jonathanTorf/3d-printer-v2/README.md

[Onshape](https://cad.onshape.com/documents/b80cc066c462fb426581e072/w/e03162f6bc79a39a6e4ea033/e/0e22e25e1b52de5b156d5392)

[Oshwlab](https://oshwlab.com/jonatan_t/stepper-motor-to-driver-board_2)

[Showcase video](https://youtu.be/BTVg7voFzN0)
