jonathanTorf/3d-printer-v2/project presentation/הצגת קהל פרויכט יוד 2026 - יונתן טורפשטיין.pptx

## פרויקט י' 2026

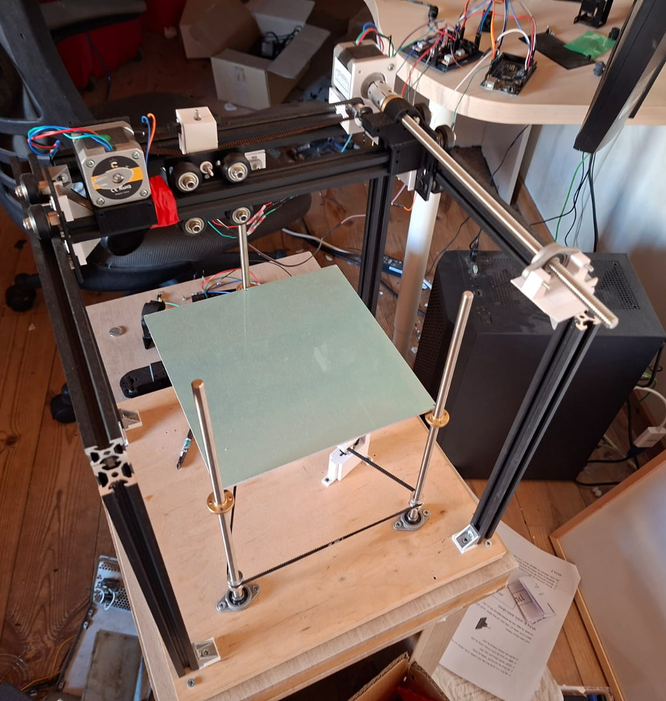
[picture p1: figure]

יונתן טורפשטיין

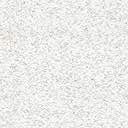
[picture p2: figure]

## מה הפרויקט שלי?

מדפסת תלת ממד שיכולה לקרוא קמצי gcode ולזוז כמו מדפסת אמיתית.
הפרויקט משתמש בבורג מוביל(lead screw) לציר ה-X, ורצועה לציר ה-Y, ציר ה-Z משתמש ברצועה כדי לסובב 3 ברגים ביחד.

שרטות .BOM

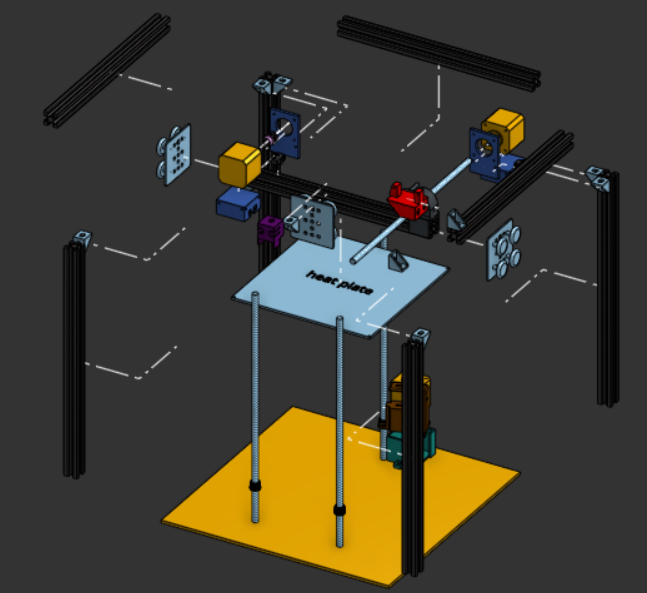
[picture p3: figure]

ציר Z.

מסילות X ו-Y.

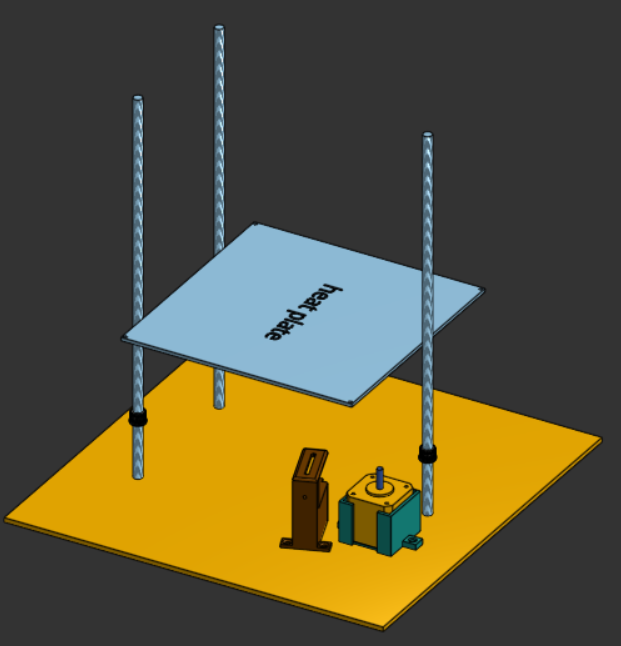
[picture p4: figure]
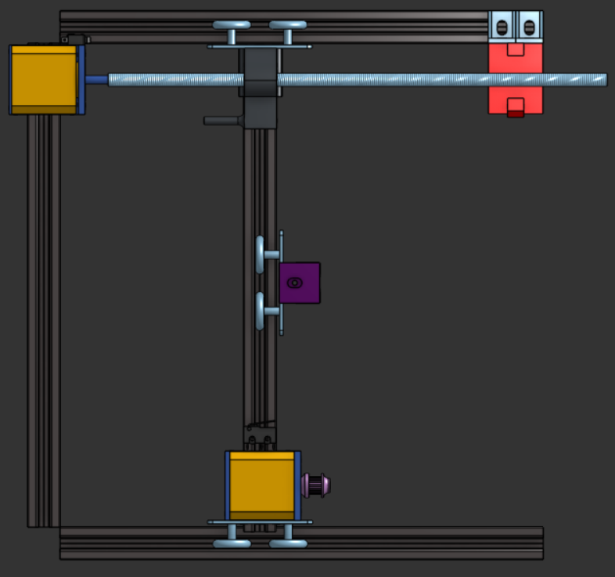
[picture p5: figure]

## עיצוב קודם נגד חדש

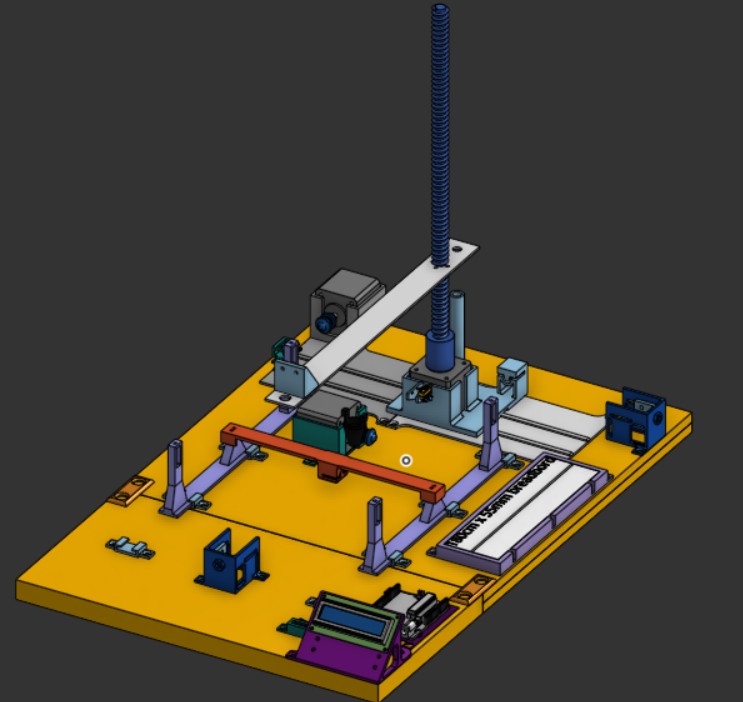
[picture p6: figure]

## אלקטרוניקה

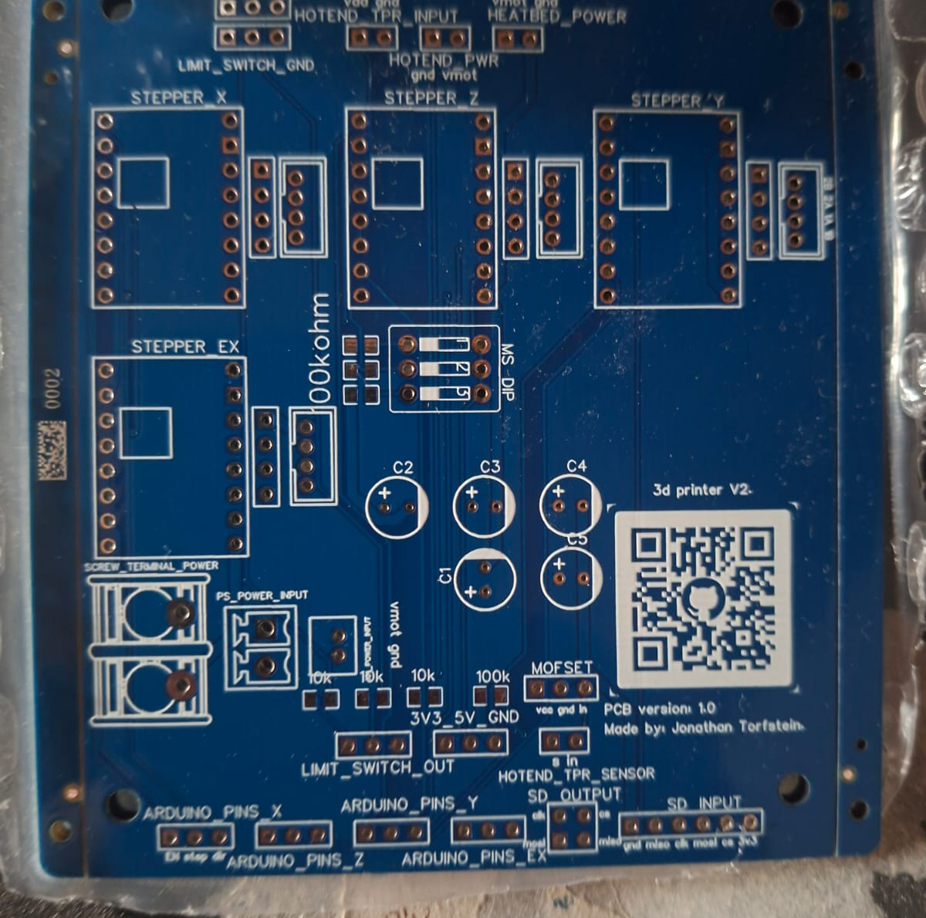
[picture p7: figure]
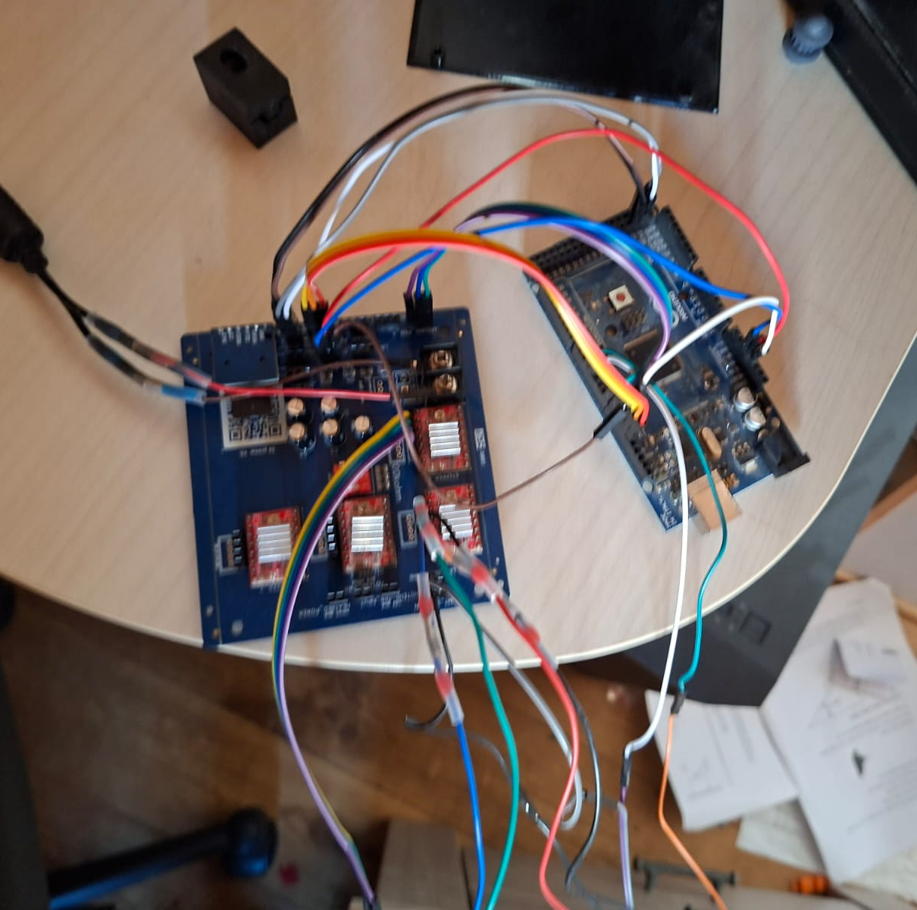
[picture p8: figure]

בפרויקט הזה השתמשתי ב-PCB, הכנתי אותו בעצמי באתר easyEDA ושלכתי אותו לייצור באתר JLCPCB.
לבקר אני משתמש ב-Arduino mega, בשביל המנועים אני משתמש ב-nema17 stepper, אם הדרייבר A4988.

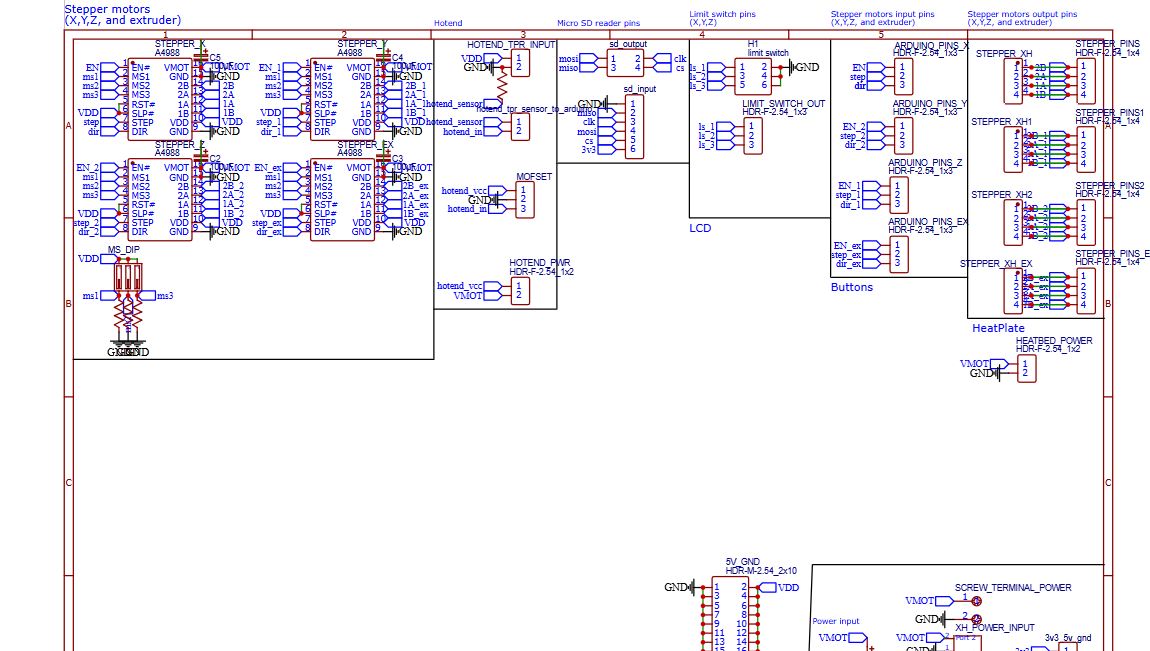
[picture p9: figure]
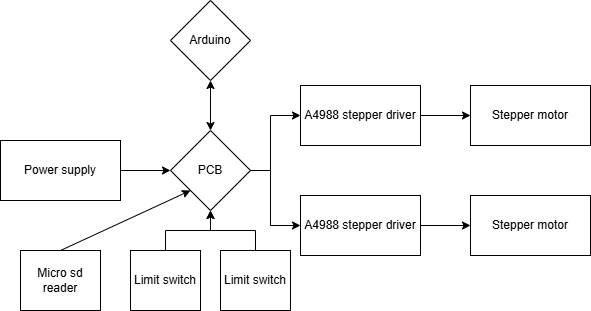
[picture p10: figure]

## Slide 5

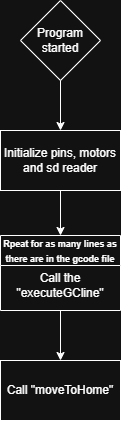
[picture p11: figure]
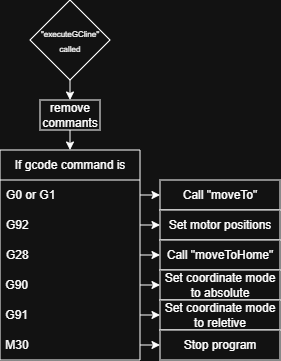
[picture p12: figure]

:gcode

דוגמה לשורה של gcode:
G1 X67 Y69 E420 F1000 ;comment
Move(67, 69, posZ, 420, 1000); //comment

## Slide 6

תוכנה.

מתוך: printer.cpp

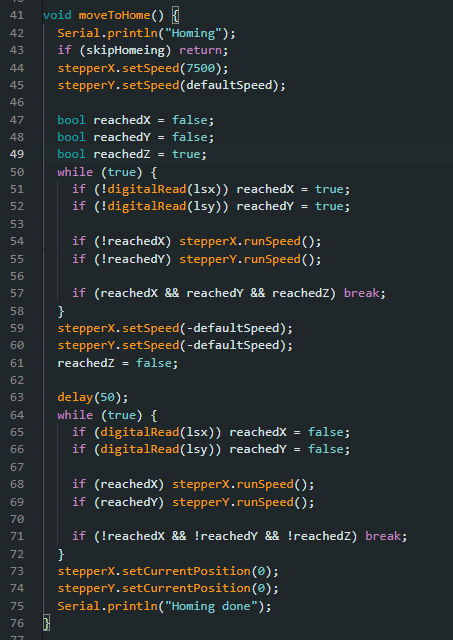
[picture p13: figure]

מתוך: movemant.h

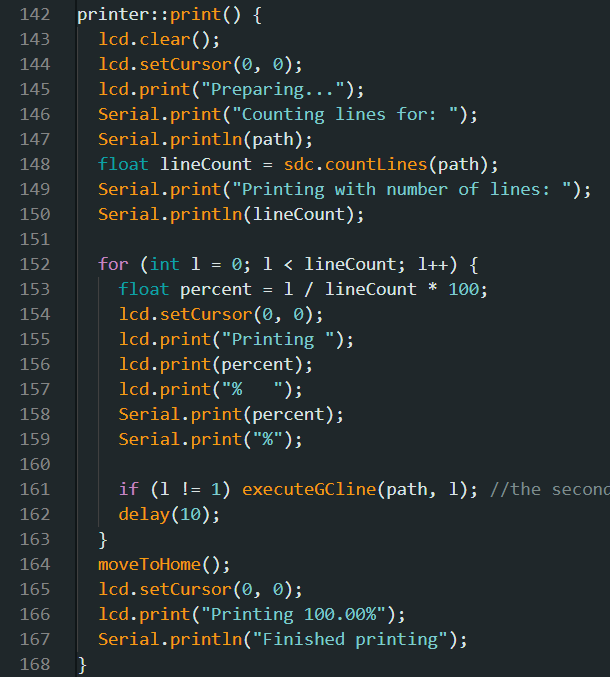
[picture p14: figure]

עדיין יש לי בעיות בתוכנה שלא הצלחתי לפתור, לדוגמא: בפונקציה שמחזירה את המדפסת ל-0,0 ציר ה-X תמיד הולך לאט, גם כשניסיתי להגביר לו את המהירות, אבל רק בפעם הראשונה שאני קורא לפונקציה הזאת.
