jonathanTorf/3d-printer-v2/project presentation/ספר פרוייקט כיתה י', יונתן טורפשטיין.docx

0 – שער:

פרויקט יוד:

מדפסת תלת ממד

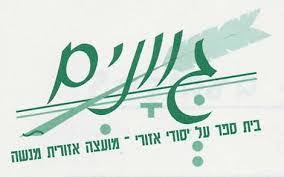
[picture p15: figure]

שם המגיש: יונתן טורפשטיין

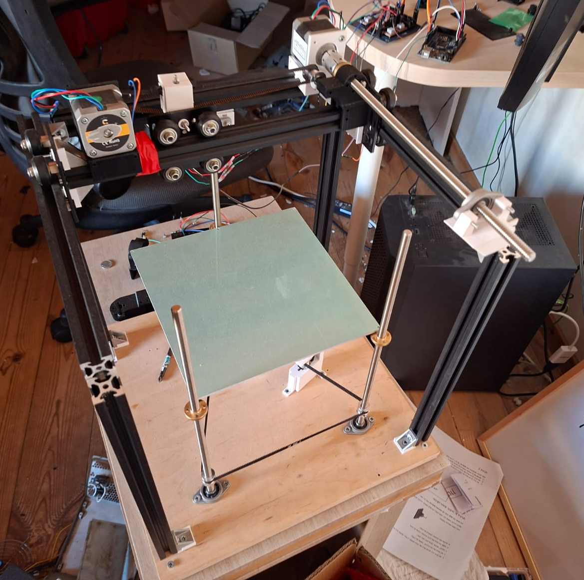
[picture p16: figure]

תאריך הגשה: 24.5.2026

של הפרויקט.github (https://github.com/jonathanTorf/3d-printer-v2/tree/main/)

1 - תוכן עניינים:

0: שער.

1: תוכן עניינים.

2: תקציר.

.gcode 2.1: הסבר קצר על

3: דרישות פרויקט.

4: מידול.-6

7-9: אלקטרוניקה.

.PCB - 10

11 – סכמת מלבנים של האלקטרוניקה.

12 – תרשימי זרימה.

12.1 – תוכנה. (https://github.com/jonathanTorf/3d-printer-v2/tree/main/arduinoIDE/main)

12.2 – סרטון הצלחה. (https://youtu.be/BTVg7voFzN0)

13 – רפלקציה.

2 – תקציר:

זה הניסיון השני שלי בלהכין מדפסת תלת ממד, בניסיון הראשון היה לי עיצוב שלא מאפשר תזוזה יציבה(אונשייפ של העיצוב הקודם (https://cad.onshape.com/documents/b952cc3ae6dde4798fa6cef6/w/a75674ccd77912fe6442e073/e/6845e0cde51841863a819568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)) המודל נבנה על הרעיון שציר ה-Z רוכב על ציר ה-Y עם מסילה מודפסת. במודל החדש הכנתי שלד יציב עם השראה ממדפסות אמיתיות ועבדתי עם ספריות להכין תזוזה שמטפלת בכמה מנועים באותו הזמן.

במהלך הבדיקות שרפתי 2 מהדרייברים שלי אז לא הגעתי ללהפעיל את ציר ה- Zואת האקסטרודר.
המודל הזה עדיין לא מדפיס בשלוש ממדים, הגעתי לציור דו ממדי מתוך קובץ.gcode

אני מתכנן להמשיך את הפרויקט הזה אחרי ההגשה עד שזה יוכל להדפיס חלקים שלמים.

:gcode – הסבר קצר על2.1

?gcodeמהו

בעיקר משומשים במכונות ייצורgcode סוג קובץ שמכיל בעיקר הוראות לתזוזה של מנועים, קבצי
.CNCכמו מדפסות תלת ממד ומכונות

נראית?gcodeאיך שורה של

G1 X67 Y69 E420 F1000

מחולקת לשני חלקים: gcode שורה ב-

: סוג הפקודה(במקרה הזה לזוז).G1

: הפרמטרים.X67 Y69 E420 F1000

זה הציר של האקסטרודר(התוכנה E מתכוונים לשני צירי התזוזה, Y ו-X
מתייחסת אלוו כמו אל ציר תזוזה).

המספרים שאחריהם הם כמה כל ציר צריך לזוז במילימטרים.

זה המהירות שלF זה המהירות של המנועים, כל המנועים צריכים להגיע ליעד שלהם באותו הזמן, F
המנוע שצריך לזוז הכי הרבה, המנועים האחרים זזים מאתים כדי שמשך התזוזה שלהם יהיה זהה.
המהירות היא בצעדים לשנייה.

3 – דרישות מהפרויקט:

gcode1: קריאה ועיבוד של קבצי

2: תזוזה מסונכרנת על צירים שיכולה להגיע לכל נקודה על המיטה.

4 – מידול:

Onshap assembly (https://cad.onshape.com/documents/b80cc066c462fb426581e072/w/e03162f6bc79a39a6e4ea033/e/0e22e25e1b52de5b156d5392):

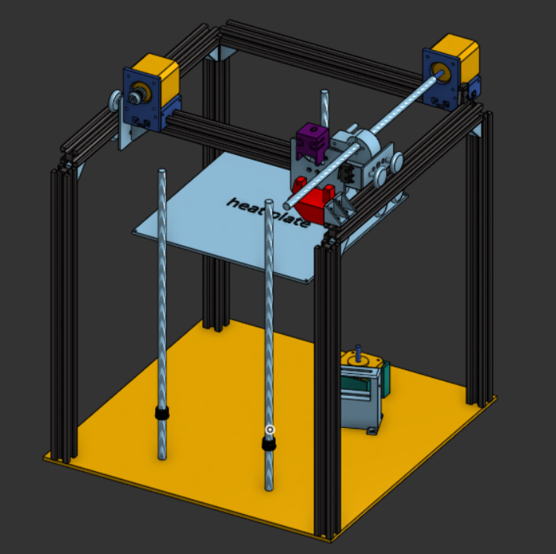
[picture p17: figure]

תיקיית שרטוטים. (https://cad.onshape.com/documents/b80cc066c462fb426581e072/w/e03162f6bc79a39a6e4ea033/e/42440a0ae2f46dab51a842b0)

Screw and belt holderשם החלק:

תמונה:

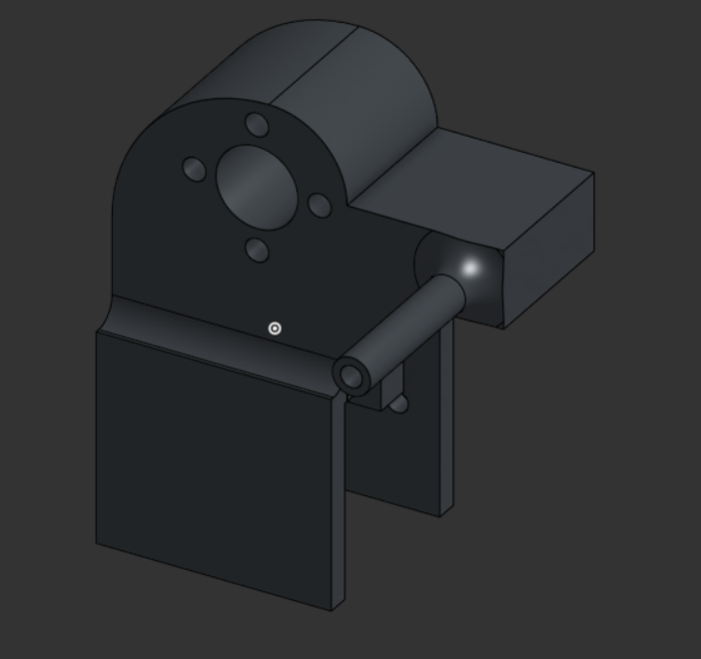
[picture p18: figure]

למוטY, ואת החגורה של ציר- X שימוש: מחבר את הבורג של ציר ה-

.Y של ציר ה-

5

Belt holderשם החלק:

תמונה:

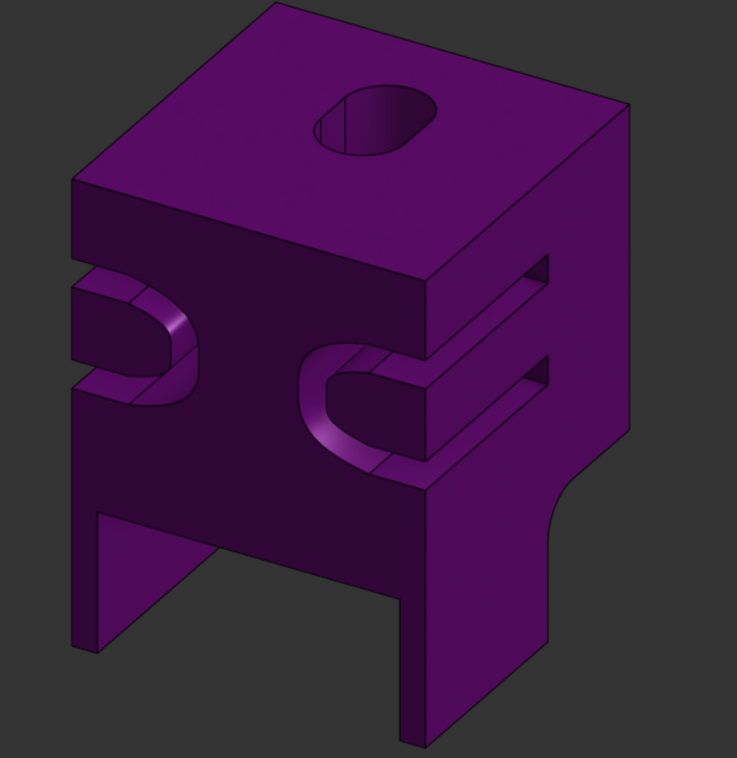
[picture p19: figure]

על הגלגלת של ראשY שימוש: מקבע את הרצועה של ציר ה-

שמחזיקה את ראש ההדפסה.

stretcher mountשם החלק:

תמונה:

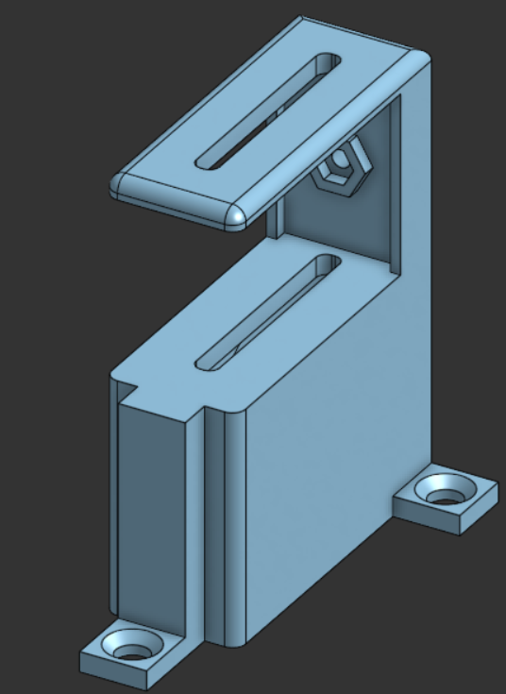
[picture p20: figure]

Z שימוש: מותח את הרצועה של ציר ה-

belt gearשם החלק:

תמונה:

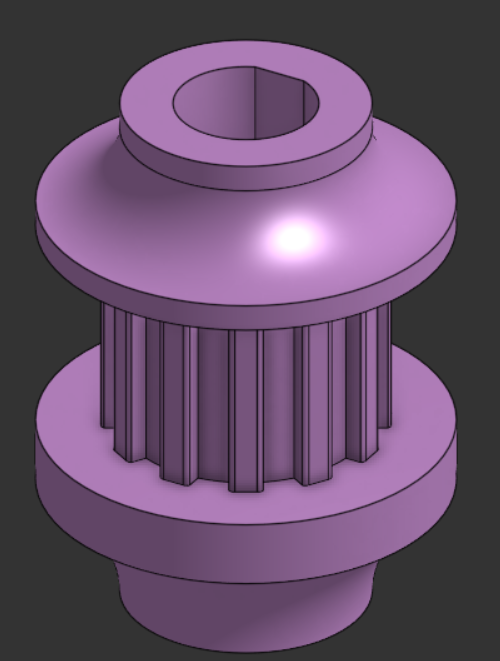
[picture p21: figure]

Yשימוש: מחבר את המנוע לרצועה בציר ה-

6

stepper mount/stepper mount wallשם החלק:

תמונה:

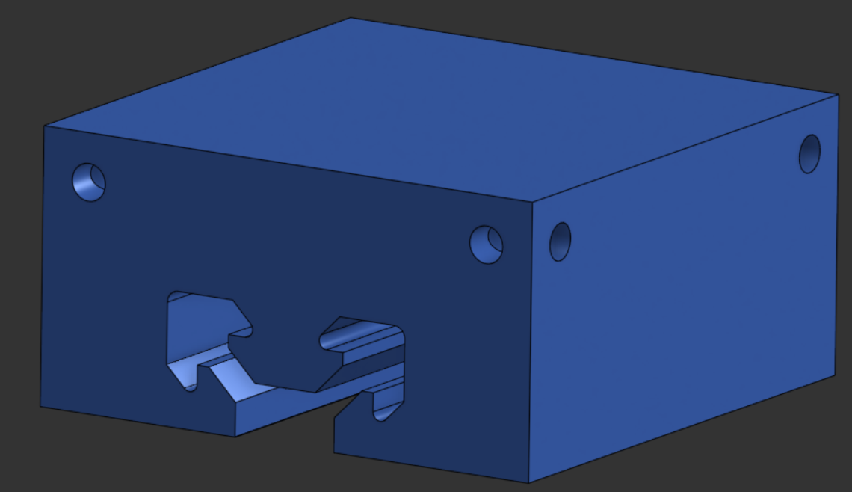
[picture p22: figure]
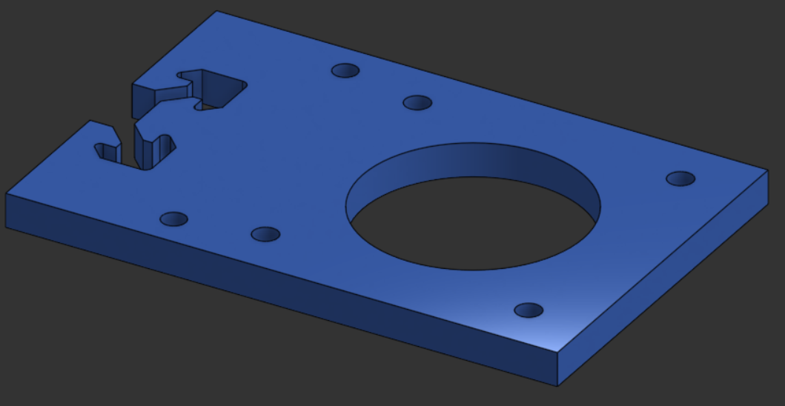
[picture p23: figure]

שימוש: מקבע את המנועים למוטות בשלד של המדפסת.

triangle padשם החלק:

תמונה:

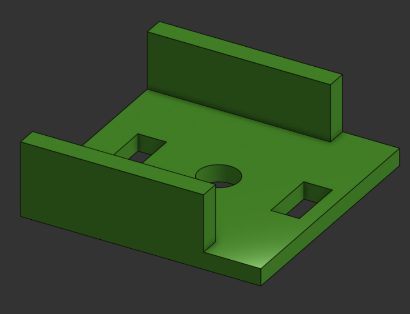
[picture p24: figure]

שימוש: מאפשר לחבר חלקים למחברים של המוטות בשלד של המדפסת בלי שהבליטות שאליהם יפריעו.

lead screw bearing holderשם החלק:

תמונה:

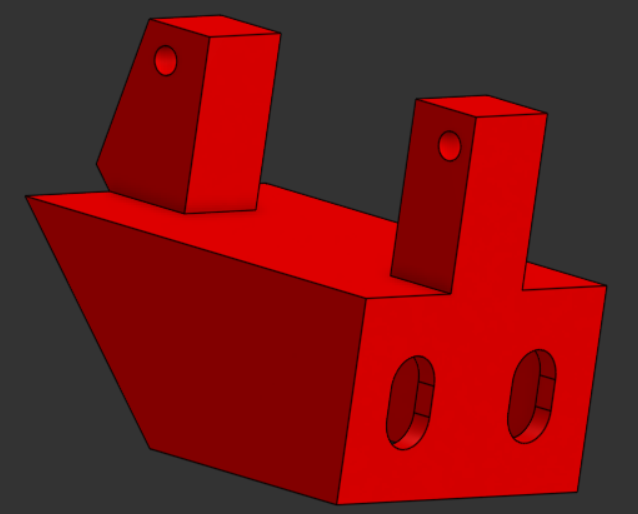
[picture p25: figure]

אבל עדיין מאפשר לו להסתובבX שמחזיק את הבורג של ציר ה- (bearingשימוש: מחזיק מסב(

7 – אלקטרוניקה

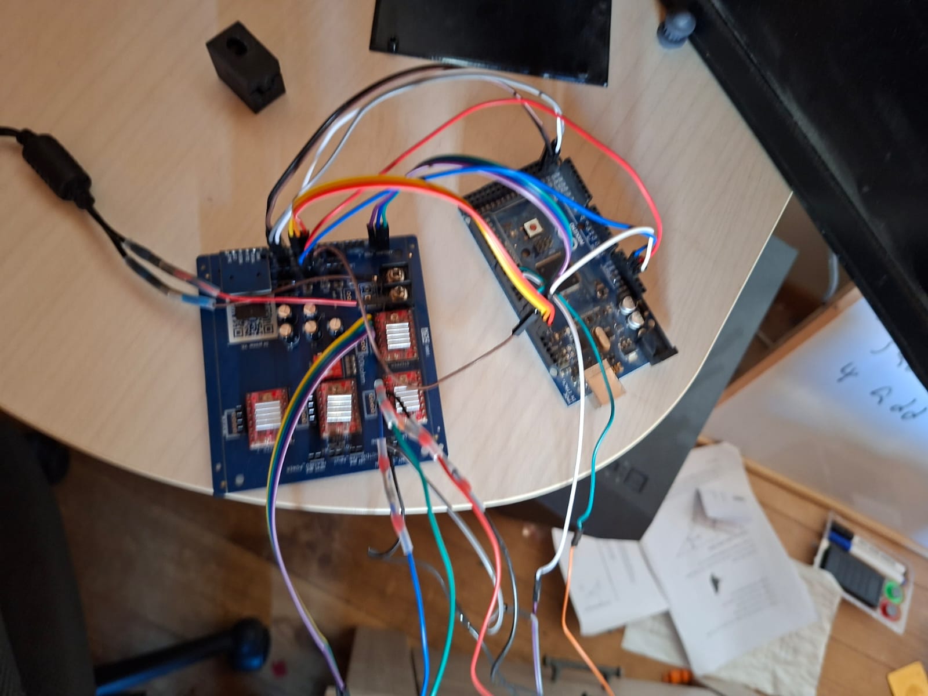
[picture p26: figure]

A4988 stepper driverשם החלק:

כמות: 2

תמונה:

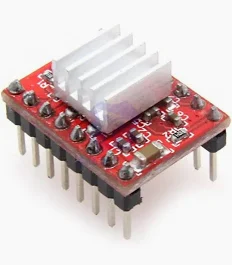
[picture p27: figure]

שימוש: מפעיל את המנועים

נימוק לבחירת הרכיב: עבדתי עם הרכיב הזה בעבר, הוא כבר מוכר לי.

8

Nema17 stepper motorשם החלק:

כמות: 2

תמונה:

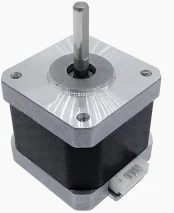
[picture p28: figure]

שימוש: מזיז את הצירים

נימוק לבחירת הרכיב: זה סוג מנוע פופולרי במדפסות תלת ממד, אמין ומשומשים במדפסות מסחריות.

Limit switchשם החלק:

כמות: 2

תמונה:

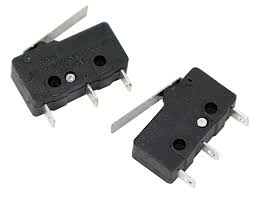
[picture p29: figure]
Micro Limit Switch (Straight Lever) - 2 ...

שימוש: מאפשרים למנועים לדעת מתי הם הגיעו לתחילת הציר

נימוק לבחירת הרכיב: לחצן מגע יבש שמעביר סיגנל דרך כרטיס בקרה לתוכנה עבור קבלת מיקום אבסולוטי במרחב לנקודת האפס של כל ציר.

9

Arduino mega 2560שם החלק:

כמות: 1

תמונה:

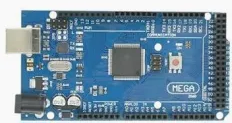
[picture p30: figure]

שימוש: הבקר ששולט על כל המערכת

נימוק לבחירת הרכיב: יש לי נסיון רב בעבודה עם הרכיב הזה, בקר חזק המסוגל להתמודד עם התוכנה של המדפסת במהירות גבוהה.

micro sd card readerשם החלק:

כמות: 1

תמונה:

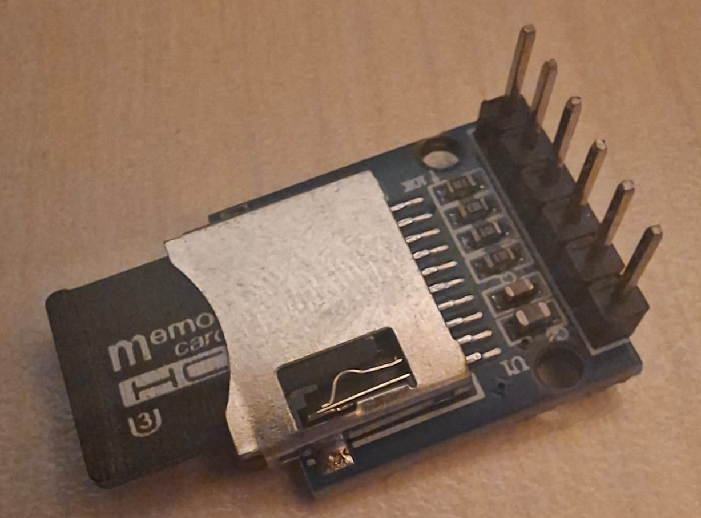
[picture p31: figure]

(ההוראות שאומרות למכונה לאן לזוז).gcode שימוש: מאחסן את הקבצים של ה-

כרטיסי SD הם דרך פופולרית להעלות קבצים למדפסות פחות מתקדמות, בחרתי בכרטיס הזה כי יש לו 5 פינים לעומת כרטיסים אחרים שיש להם 10.

PCB – 10

oshwlab (https://oshwlab.com/jonatan_t/stepper-motor-to-driver-board_2)

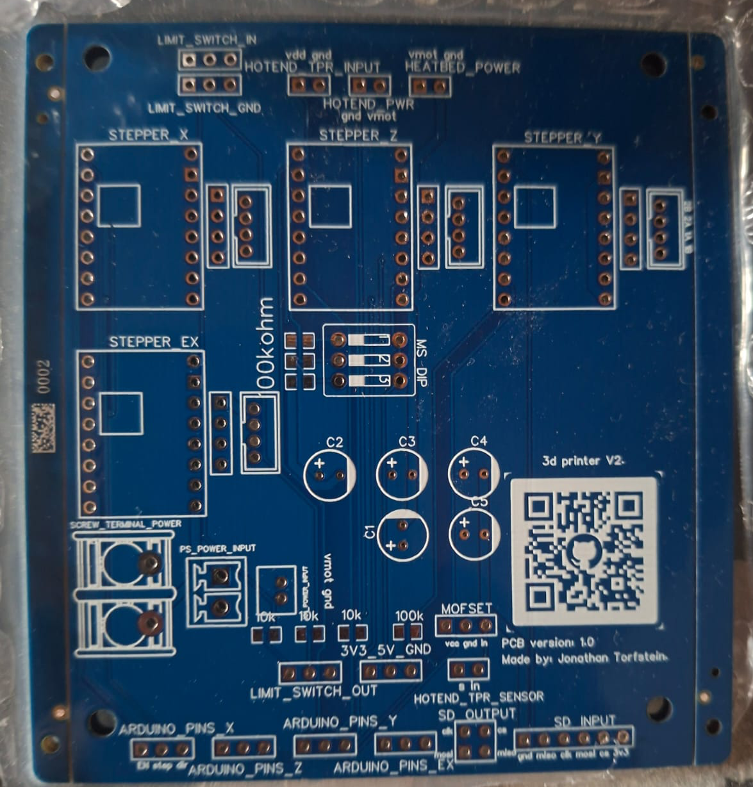
[picture p32: figure]

זה כרטיס PCB שתכננתי ושלחתי לייצור מהאתר JLCPCB.

11 – סכמת מלבנים של האלקטרוניקה:


12 – תרשימי זרימה

Main.ino executeGCline()


12.1 – תוכנה. (https://github.com/jonathanTorf/3d-printer-v2/tree/main/arduinoIDE/main)

12.2 – סרטון הצלחה. (https://youtu.be/BTVg7voFzN0)

בסרטון השתמשתי בטכניקה שנקראת הדפסת עט((pen printing שבה במקום לחבר ראש הדפסה, משתמשים בעט(או עיפרון) כדי לראות את הצורה שהמדפסת מנסה להכין(בסרטון הייתי צריך להחזיק את הרצועה כדי שהיא תישאר מתוחה).

13 – רפלקציה:

הפרויקט הזה בהכלת היה צעד קדימה מהניסיון הקודם שלי בלהכין מדפסת.
רוב ההשקעה שלי הייתה בלהכין שלד יציב שמאפשר תנועה לכל ציר בנפרד, ובמעגל המודפס. הדברים העיקריים שהייתי משנה בסדר עבודה שלי היה להתחיל לעבוד על המעגל המודפס בזמן שהרכיבים היו בדרך, זה היה מאפשר לי עבודה יעילה במקביל במקום המתנה ארוכה בין כל שלב לשלב הבא.

, כדי שלאX בבורג כמו בציר ה-Yבמודל הבא שלי אני גם ירצה להחליף את הרצועה של ציר ה-
יהיה לי בעיה עם המתיחות של הרצועה.

, תוכנה פתוחהmarlin בתחילת הפרויקט רציתי להשתמש בתוכנה מוכנה, ניסיתי להוריד את
אחרי כמה ניסיונות.Arduino mega שנועדה גם למדפסות אמיתיות וגם לבקרים כמו
כושלים להפעיל את התוכנה, החלטתי שאני מעדיף תוכנה משלי שבה יש לי שליטה והבנה מלאה,
.gcode זאת גם הייתה הזדמנות ללמוד על דברים כמו
