jonathanTorf/3d-printer-v2/project presentation/מחוון.pdf

רמת קושי עמודה 2 עמודה 1

| מיומנות פרויקט עובד מידול אלקטרוניקה תיכנות ספר פרויקט ציון כולל נ ב ג
| הערכה מספרית 80 90 80 90 75 70% 90% 110%
| רמת קושי ב ב ג ג ב
| ציון משוקלל 72 81 88 99 67.5
| משקל 30% 15% 15% 20% 20%
| רכיב 21.6 12.15 13.2 19.8 13.5 80.25
