jonathanTorf/3d-printer-v2/parts order list/3d printer order wave 2 parts list.docx

3d printer order wave 2 parts list

name | link | amt | ordered | details
A4899 | link (https://he.aliexpress.com/item/1005011534537711.html) | 8(2 sets of 4) | V
Xh connector kit | link (https://he.aliexpress.com/item/1005006766588357.html) | 2 boxes | V | Straight needle
mosfet | link (https://he.aliexpress.com/item/1005004533156263.html) | 1 set of 10 | V | Type: irlz44n
Printing board | link (https://he.aliexpress.com/i/33012258110.html?gatewayAdapt=glo2isr) | 1 | V | Size:214x214
Lead screw(to replace the Y axis belt) | link (https://he.aliexpress.com/item/1005004978968470.html) | 1 | V | Length: 200, Lead: 2, Pitch: 2
capacitors | link (https://he.aliexpress.com/item/1005002075527957.html) | 1 | V | 25v 100uf
Wire spool | link (https://he.aliexpress.com/item/1005006467312913.html) | 4 | V | Awg:16, length:10m, One of each color: black, red, green, blue
T slot beam | link (https://he.aliexpress.com/item/1005012852495434.html) | 1 | V | Length: 350mm
hotend | link (https://he.aliexpress.com/item/4000289104191.html) | 1 | V | 12v Teflon tube
Dp to Dp cable(male to male) | link (https://he.aliexpress.com/item/1005006853172978.html) | 1 | V | Color: black
USBC to jack adapter | link (https://he.aliexpress.com/item/1005007090595778.html) | 1 | X | Size:7.9x5.5

3d printer order wave 2 parts list

name | link | amount | details
Resistor kit | link (https://he.aliexpress.com/item/1005006179281226.html) | 1 | 600 pcs set
Arduino connectors | link (https://he.aliexpress.com/item/1005001418544370.html) | 1 | 8x1 female
Arduino connectors | link (https://he.aliexpress.com/item/1005010782197285.html) | 2 | male
Female connector kit | link (https://he.aliexpress.com/item/1005007490400337.html) | 2
solder
Lead screw nut | link (https://he.aliexpress.com/item/1005006362060573.html) | 1 | 2mm
wick
Male to female wires
