jonathanTorf/3d-printer-v2/arduinoIDE/main/printer.cpp

#include "printer.h"
#include "sd.h"
#include "gcodeRead.h"
#include "movemant.h"
#include "joystick.h"
#include "UI.h"
#include "hotend.h"
#include <Wire.h>

const int lsx = 37;
const int lsy = 3;
const int lsz;
const int enx = 24;
const int eny = 7;
const int enz;

const int ms1 = 39;
const int ms2 = 40;
const int ms3 = 41;

const bool skipHoming = false;
bool printing = true;

sdCard sdc(53);
joystick jStick(38, A2, A3);
UI ui;
hotend HE(13, A4);

printer::printer() {}

printer::begin() {
  Serial.println("program starting");

  sdc.begin();
  jStick.begin();
  ui.begin();

  pinMode(lsx, INPUT_PULLUP);
  pinMode(lsy, INPUT_PULLUP);
  pinMode(lsz, INPUT_PULLUP);
  pinMode(enx, OUTPUT);
  pinMode(11, OUTPUT);
  pinMode(10, OUTPUT);
  pinMode(eny, OUTPUT);
  pinMode(enz, OUTPUT);
  digitalWrite(enx, LOW);
  digitalWrite(eny, LOW);
  digitalWrite(enz, LOW);

  movemantInit();
  moveToHome();
  // moveTo(-5, true, 0, false, 0, false, 0, false, 25);
  // moveTo(2.5, true, 0, false, 0, false, 0, false, 25);
}

printer::selectFunction() {
  int func = -1;
  while (jStick.getDirX() != 1) {
    delay(100);
    // Serial.println(jStick.getDirX());
  }

  while (jStick.getDirY() != -1) {
    if (jStick.getDirX() != 0) {
      func += jStick.getDirX();
      if (func < 0) func = 0;
      if (func > funcAmt) func = funcAmt;
      ui.printFunction(func);

      Serial.print("Function: ");
      Serial.println(func);
    }
    while (jStick.getDirX() != 0) delay(100);

    delay(100);
  }
  Serial.println("jStick pressed");
  switch (func) {
    case 0:
      lcd.setCursor(0, 0);
      lcd.print("[<]ext [>]pnt");
      selectPath();
      break;
    case 1:
      moveToHome();
      break;
    case 2:
      lcd.setCursor(0, 0);
      lcd.print("Select axsis:");
      String axis[] = { "X: [>]slt [<]ext", "Y: [>]slt [<]ext", "Z: [>]slt [<]ext" };
      int axisIndex = ui.selectFrom(axis, 3);

      break;
  }
}

printer::selectPath() {
  int maxFiles = 20;
  path = "/";
  char outFiles[maxFiles][32];
  File dir = SD.open(path);

  if (!dir) {
    Serial.println("Failed to open directory");
    lcd.clear();
    lcd.setCursor(0, 0);
    lcd.print("No files found:(");
    lcd.setCursor(0, 1);
    lcd.print("RST & try again.");
    return;
  }

  int count = 0;

  while (true) {
    File entry = dir.openNextFile();

    if (!entry) break;

    if (entry.isDirectory()) {
      entry.close();
      continue;
    }

    String name = entry.name();
    name.toLowerCase();

    if (name.endsWith(".gx")) {
      if (count < maxFiles) {
        strncpy(outFiles[count], name.c_str(), 31);
        outFiles[count][31] = '\0';

        Serial.print("GX File Found: ");
        Serial.println(outFiles[count]);

        count++;
      }
    }
    entry.close();
  }
  dir.close();

  Serial.print("Total GX files: ");
  Serial.println(count);

  //while (jStick.pressed()) delay(100);
  int fileNum = 0;
  lcd.setCursor(0, 1);
  lcd.print(outFiles[0]);
  Serial.println(outFiles[0]);
  while (jStick.getDirX() != 1) {
    if (jStick.getDirY() != 0) {
      fileNum -= jStick.getDirY();
      if (fileNum < 0) fileNum = 0;
      else if (fileNum > count - 1) fileNum = count - 1;
      lcd.setCursor(0, 1);
      lcd.print("                ");
      lcd.setCursor(0, 1);
      lcd.print(outFiles[fileNum]);
      while (jStick.getDirY() != 0) delay(100);
    }

    delay(100);
  }
  path = outFiles[fileNum];

  Serial.print("Path selected: ");
  Serial.println(path);
  print();
}

printer::print() {
  lcd.clear();
  lcd.setCursor(0, 0);
  lcd.print("Preparing...");
  Serial.print("Counting lines for: ");
  Serial.println(path);
  float lineCount = sdc.countLines(path);
  Serial.print("Printing with number of lines: ");
  Serial.println(lineCount);

  for (int l = 0; l < lineCount; l++) {
    float percent = l / lineCount * 100;
    lcd.setCursor(0, 0);
    lcd.print("Printing ");
    lcd.print(percent);
    lcd.print("%   ");
    Serial.print(percent);
    Serial.print("%");

    if (l != 1) executeGCline(path, l);  //the second line in gcode files is a preview image
    delay(10);
  }
  moveToHome();
  lcd.setCursor(0, 0);
  lcd.print("Printing 100.00%");
  Serial.println("Finished printing");
}
