jonathanTorf/3d-printer-v2/arduinoIDE/main/hotend.h

#ifndef HOTEND_H
#define HOTEND_H

class hotend {
  private:
    int hotendPin;
    int thermistorPin;
    float kp = 5;
    float ki = 0.08;
    float kd = 5;

    long lastTime = 0;
    float cumError = 0;
    float lastError = 0;

  public:
    int targetTemp = 0;
    
    hotend(int hep, int tp);
    float getTemp();
    void updatePID(int sp);
    void waitForTemp(int temp);
};

#endif
