jonathanTorf/3d-printer-v2/arduinoIDE/main/sd.h

#ifndef SD_HELPER_H
#define SD_HELPER_H

#include <SPI.h>
#include <SD.h>

class sdCard {
  private:
    int csPin;

  public:
    sdCard(int cs);
    begin();
    String readLine(const char* path, int targetLine);
    writeLine(const char* path, int targetLine, String newLine);
    int getGXFiles(const char* path, String outFiles[], int maxFiles = 20);
    int countLines(const char* path);
};

#endif
