jonathanTorf/3d-printer-v2/(commit log)

2026-01-15 Clean up URLs in parts list
    Removed duplicate and lengthy URLs for V-slot wheels and beams, and added a new URL for lead screw nut block.
2026-01-18 Update parts list with new items and links
    Added links for additional components and a dual shaft motor.
2026-01-19 Fix link for V-slot wheels
    Updated the link for V-slot wheels in the parts list.
2026-03-18 Create pcb part checklist
2026-03-23 Add sd reader to pcb part checklist
2026-04-08 Update pcb part checklist
2026-04-08 Fix typo in temperature sensor entry
2026-04-24 Rename Screenshot 2026-04-24 092822.png to pcb.png
2026-04-26 Add G90/G91 and M82/M83 stubs; add movemant.h
    Introduce empty handlers in gcodeRead.h for G90 (absolute coords), G91 (relative coords), M82 (extruder absolute) and M83 (extruder relative) as placeholders for future implementation. Also add a new movemant.h header file (stub) to support upcoming movement-related code. These changes prepare the codebase for implementing coordinate mode and extruder mode handling without altering existing behavior.
2026-04-30 Use pin 2 with pull-up and fix homing logic
    Change limit-switch pin from 0 to 2 and enable INPUT_PULLUP in setup. Invert the digitalRead check to match active-LOW pull-up wiring, and initialize reachedX/reachedZ as true so only Y homing is performed. Add Serial prints for homing start/finish for debugging. Files changed: arduinoIDE/main/main.ino, arduinoIDE/main/movemant.h.
    [main.ino, movemant.h]
2026-05-01 Increase default speed and refine homing sequence
    Add a 1s startup delay in setup, raise defaultSpeed from 500 to 1000, and extend the homing routine to include an additional Y-axis homing loop (set Y speed, poll lsy, run Y until homing flags clear). These changes aim to give sensors time to settle on boot, increase movement responsiveness, and improve the homing sequence reliability.
2026-05-09 Adjust movement scaling and startup sequence
    Introduce a step/mm scale and tune homing/startup behavior. Added stmmx (1500) to movemant.h and apply it to convert relative X positions and to scale stepperX max speed (F * stmmx / 60). Use defaultSpeed for homing setSpeed calls. In main.ino enable the startup block, add a short delay and an initial small move, and nest the original long move sequence behind an if(false) for now. Also fix missing semicolons on Serial.println calls in gcodeRead.h.
    [gcodeRead.h, main.ino, movemant.h]
2026-05-10 Create ספר פרוייקט כיתה י', יונתן טורפשטיין.docx
2026-05-11 Update ספר פרוייקט כיתה י', יונתן טורפשטיין.docx
2026-05-13 Create ~$ר פרוייקט כיתה י', יונתן טורפשטיין.docx
2026-05-25 Create arduino and pcb holder.svg
2026-06-04 Create הצגת קהל פרויכט יוד 2026 - יונתן טורפשטיין.pptx
2026-06-04 Update הצגת קהל פרויכט יוד 2026 - יונתן טורפשטיין.pptx
2026-09-19 added hotend class
2026-09-19 updated pid k vslues
2026-09-20 updated hotend PID to be compatible with my psu
    psu cant handle pwm inputs
2026-11-07 Create 3d printer order wave 2 parts list.docx
2026-11-08 Create ~$ printer order wave 2 parts list.docx
2026-11-11 Update 3d printer order wave 2 parts list.docx
